princeedward/senior_thesis/README.md

senior_thesis
=============

A repo for codes and tex file of my senior design and thesis
