princeedward/senior_thesis/Tex/body/chapter3.tex

%%==================================================
%% chapter03.tex for SJTU Bachelor Thesis
%% version: 0.5.2
%% Encoding: UTF-8
%%==================================================

% \bibliographystyle{sjtu2} %[此处用于每章都生产参考文献]

\chapter{通用控制电路设计}
\label{chap:electricalSystem}
模块化机器人的各个模块都是可以独立工作的个体。从上一章的设计可知，每个模块都有一个核心板载系统来对本模块的基本功能进行控制。这一设计思路在其它模块化机器人上也有所体现。例如美国加州大学戴维斯分校的Graham G. Ryland等人\upcite{ryland2010design}设计的模块化机器人系统，每个模块是包含四个自由度的可以独立控制并运动的个体。而个体之间通过通信和协议来完成作为组合的总体所实现的功能。在本设计中，因为每个模块都有不同的功能，进行拼装后的实体的机器人通过协同来实现全部功能。为了使设计的硬件能在最大程度上实行公用，本设计将机器人电路进行拆分，并对电路实现了模块化。

每个机器人模块都将实现作为一个模块的基本功能，如实现与其他模块的通信；单独的程序上传与下载、与在线调试；对于自身模块的电源管理；与外部其他系统的通讯；简单的片上调试按钮和指示用数码管和LED。据此本方案设计了每个模块都要使用的通用模块控制电路。而对于不同模块的不同功能需求，本方案设计了大量的外设电路，每一个模块将会在功能性外设及接口设计部分进行讨论与说明。这样的好处是使每一个模块都拥有其工作所用的资源而不会有资源的浪费。例如，用于定位的IMU模块只有地盘模块需要使用。而上层实现其他功能的模块，如机械手并不需要使用，这里没有把其集成在通用板上，是极大的避免了资源的浪费。为了能够使用这些外设电路，本设计已经将片上所有资源系数引出。这样做同时还可供未来通用板的扩展。

以下各小节将对整个机器人系统的电路系统进行详细阐述。

\section{通用模块控制电路}
通用电路板本着简单，稳定，可以快速开发和方便部署的原则进行了设计。控制芯片选用了引脚众多，功能强大和文档完善的Freescale公司的MC9S12XS128单片机。本设计使用的是拥有112个引脚的版本。这款芯片的特点是低功耗、高集成、易于扩展，自带看门狗计数器、PWM输出、增强型捕捉定时器\upcite{xn2012baseon}。在本设计中，将通用控制电路板分为两个部分，一个部分是包含BWM程序烧写在线调试器，复位按键和单片机芯片的最小系统；另一部分是提供通用电路功能的接口板。这样设计而不是直接将单片机焊接在接口板上的原因是，一旦单片机烧毁，可以同过更换最小系统来使电路板恢复使用，而不用丢弃整个电路板基板上昂贵芯片。

下面的部分将对这两个模块进行详细的介绍。

\subsection{最小系统}
最小系统的电路图如图\ref{fig.CoreSch} 所示。最小系统实物图如图\ref{fig.CorePhoto} 所示。 \\
\begin{figure}[!htp]
  \centering
  
  \bicaption[fig.CorePhoto]{最小系统实物图}{最小系统实物图}{Fig}{the Minimal Core System}
\end{figure}
\begin{figure}[!htp]
  \centering
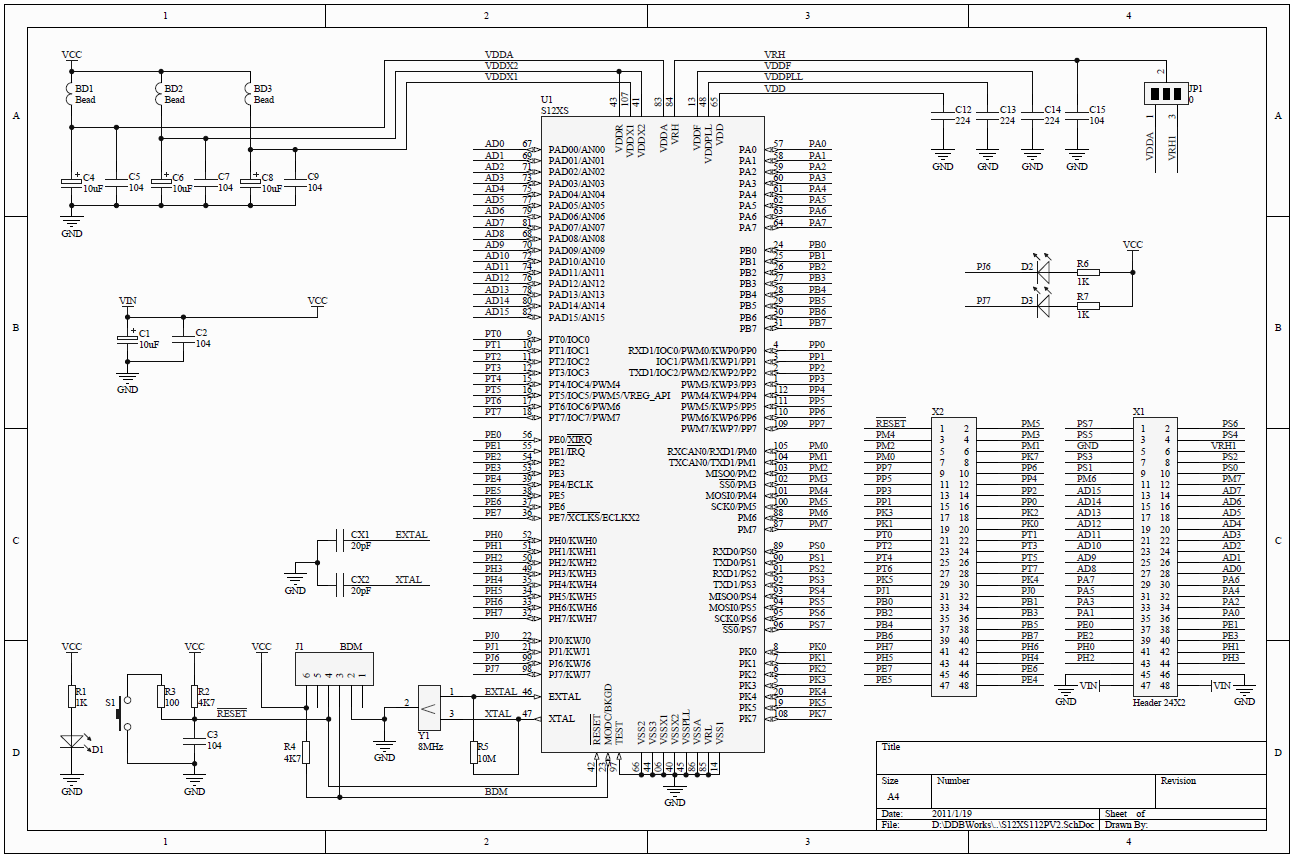
[picture p1: Tex/figures/chap3/CoreBoard.PNG]
  
  \bicaption[fig.CoreSch]{最小系统电路图}{最小系统电路图}{Fig}{Schematic of the Minimal Core System}
\end{figure}

这块最小系统板上有一个16MHz的晶振连接至芯片。芯片正常工作时的频率是由锁相环（PLL）超频到40MHz的。这块最小系统还有一个复位键，引入芯片RESET引脚，将检测电路的下降沿进行复位。同时最小系统上还提供一个BWM程序上传和下载及在线调试模块。片上提供128k片上RAM，可以用来储存芯片执行用程序。还有一个独立的电源管理模块，以提供稳定的5v电压给单片机工作。之所以称为最小系统，就是因为以上是这块芯片的全部功能元件。如原理图所示，这块最小系统的其他功能就是简单的将单片机所有引脚引出。 

\subsection{功能接口板}
功能接口板是通用模块控制电路的核心部分。它具有承上启下的作用，得到最小系统引出的单片机全部空余引脚，并对其功能进行设计。其电路图如图\ref{fig.BaseSch} 所示。 其共分为电源管理，CAN总线，单片机接口，电压测试单元，串口通讯，数码管显示单元，LED及案件阵列和引出接口几部分。 
\begin{figure}[!htp]
  \centering
  %\bicaption[fig.BaseSch]{功能接口板电路图}{功能接口板电路图}{Fig}{Schematic of Base Board}
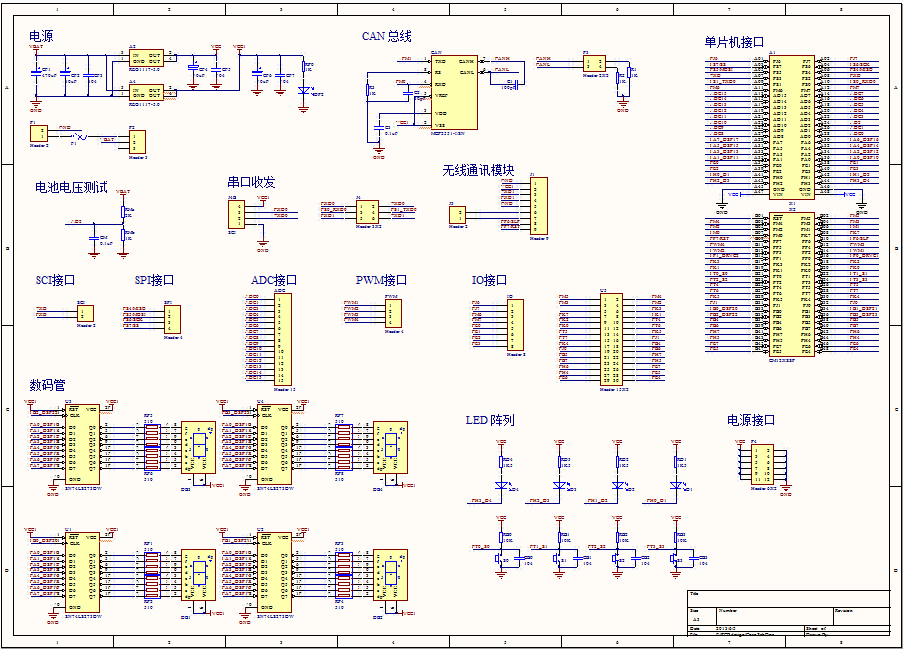
[picture p2: Tex/figures/chap3/CoreBoardSchematic.PNG]
  
  \bicaption[fig.BaseSch]{功能接口板电路图}{功能接口板电路图}{Fig}{Schematic of Base Board}
\end{figure}

其中电源管理部分的电路如图\ref{fig.BaseScrMg}。使用两片1117输出两个5v电压，为了使电流相差较大模块之间不会相互干扰。其中一个给单片机及通讯模块供压，电流小，对电流稳定性要求高；而另一路主要给外设电路供压。 
\begin{figure}[!htp]
  \centering
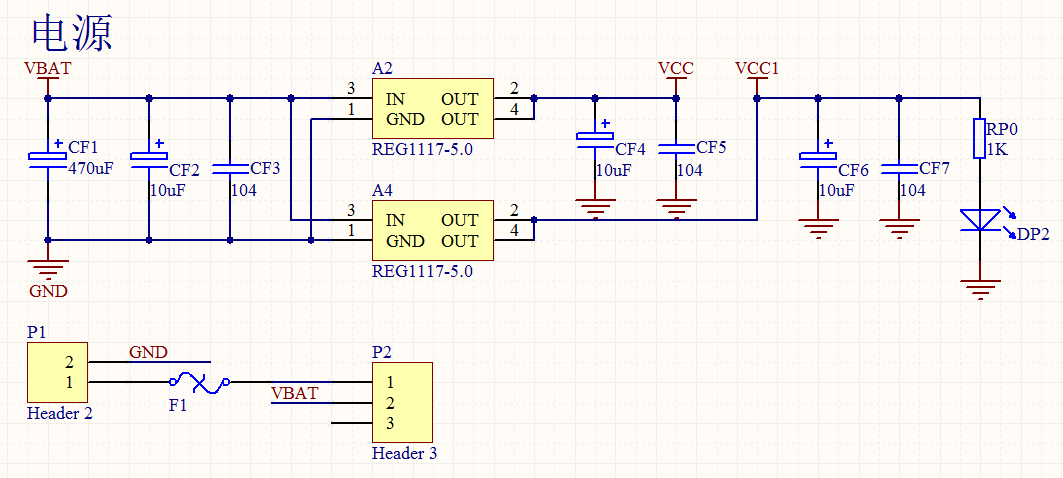
[picture p3: Tex/figures/chap3/CoreBoardPowerMg.PNG]
  
  \bicaption[fig.BaseScrMg]{电源管理电路原理图}{电源管理电路原理图}{Fig}{Schematic of Power Source Management Unit}
\end{figure}

CAN总线电路图如图所示\ref{fig.BaseCAN} 。用一块Microchip公司生产的MCP2511作为单片机内置CAN模块的Transceiver，将CAN端口数据打包编码后传输到总线中去。前面已经介绍过了这款机器人将打破传统的接触式传输连线，而是使用光学方法进行数据传输，其中这里CAN总线的输出口，就是要连接到光学传输接口板上。关于光学传输接口板的具体信息将在下面的模块间通讯接口小节进行详细的介绍。
\begin{figure}[!htp]
  \centering
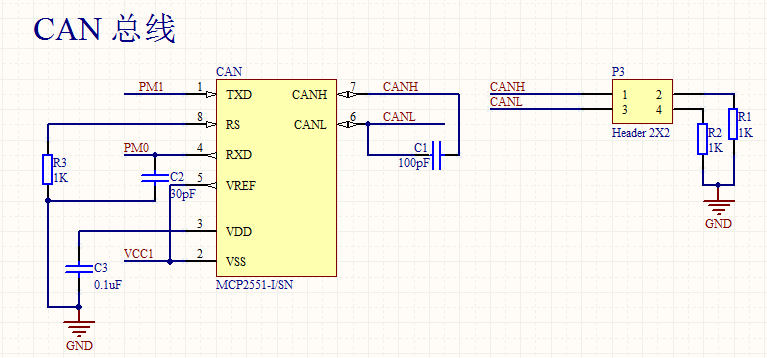
[picture p4: Tex/figures/chap3/CoreBoardCANBus.PNG]
  
  \bicaption[fig.BaseCAN]{CAN电路原理图}{CAN电路原理图}{Fig}{Schematic of CAN Bus Unit}
\end{figure}

CAN总线2.0协议\upcite{bosch1991can}是由博世公司提出被提供支持的。因为其两线制的机制，和可以同时连接非常多个模块，并能组织各个节点模块共同工作的特点而大量应用在汽车领域。其传输速度快，稳定性强的特点也为其能轻松移植到机器人系统中来提供了可行性。相对较少的接线同时也意味着极大的容错率，这就是本设计选择CAN总线为模块间传输工具的原因。这一设计的灵感来源于Ying Zhang等人\upcite{zhang2002massively}的研究。

功能接口板的PCB设计图如图\ref{fig.CorePCB} 所示。其虚拟实物图如图\ref{fig.CoreReal} 所示，3D立体仿真图如图\ref{fig.Core3D} 所示。 
\begin{figure}
  \centering
  \subfigure[PCB正面]{
    \label{fig:corepcb:a} %% label for first subfigure
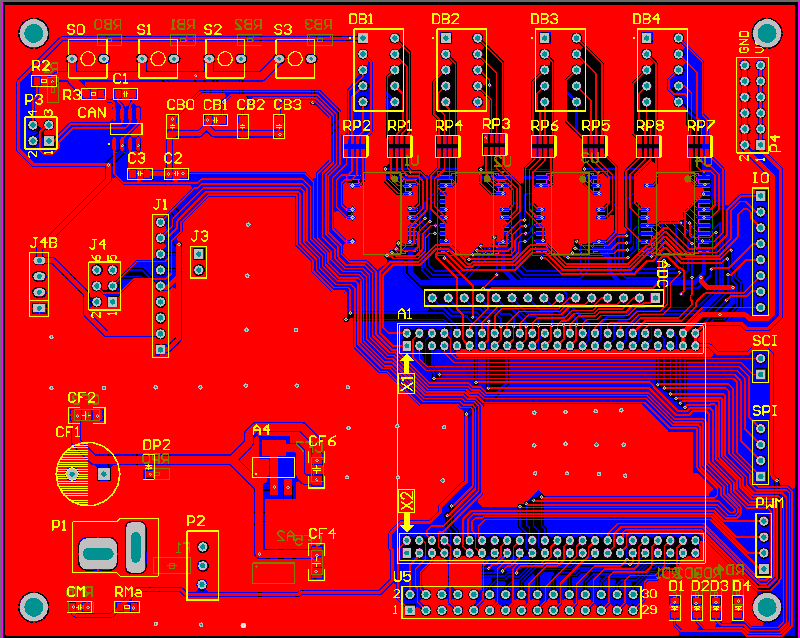
[picture p5: Tex/figures/chap3/CoreBoardTop.PNG]
    }
  \hspace{1in}
  \subfigure[PCB背面]{
    \label{fig:corepcb:b} %% label for second subfigure
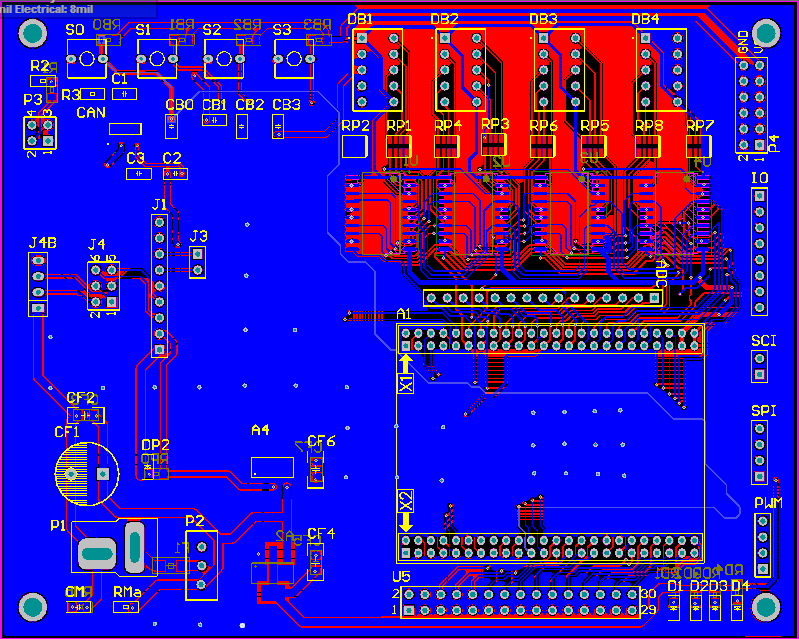
[picture p6: Tex/figures/chap3/CoreBoardBottom.PNG]
    }
  \bicaption[fig.CorePCB]{功能接口板的设计PCB样图}{功能接口板的设计PCB样图}{Fig}{The PCB View of Main Base Board}
\end{figure}
\begin{figure}
  \centering
  \subfigure[PCB正面]{
    \label{fig:corereal:a} %% label for first subfigure
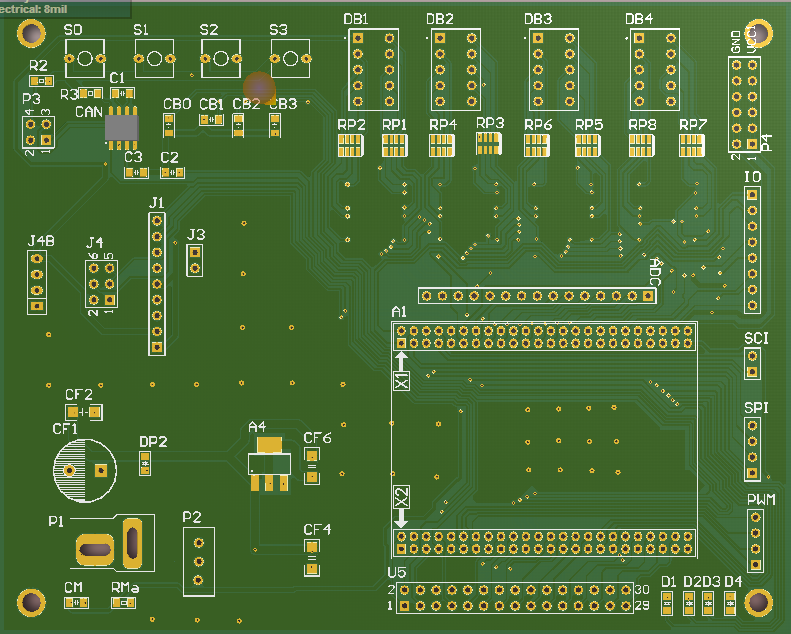
[picture p7: Tex/figures/chap3/CoreBoardManTop.PNG]
    }
  \hspace{1in}
  \subfigure[PCB背面]{
    \label{fig:corereal:b} %% label for second subfigure
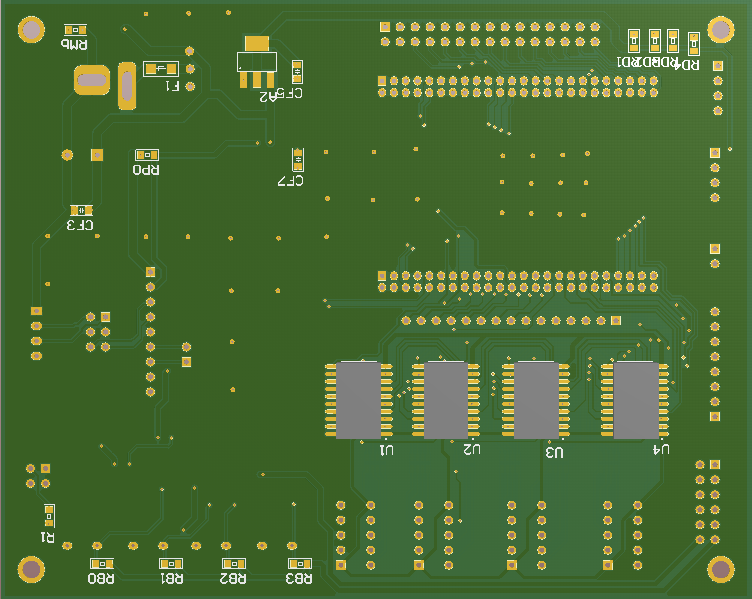
[picture p8: Tex/figures/chap3/CoreBoardManBottom.PNG]
    }
  \bicaption[fig.CoreReal]{功能接口板的虚拟实物图}{功能接口板的虚拟实物图}{Fig}{The Virtual View of Main Base Board}
\end{figure}
\begin{figure}[!htp]
  \centering
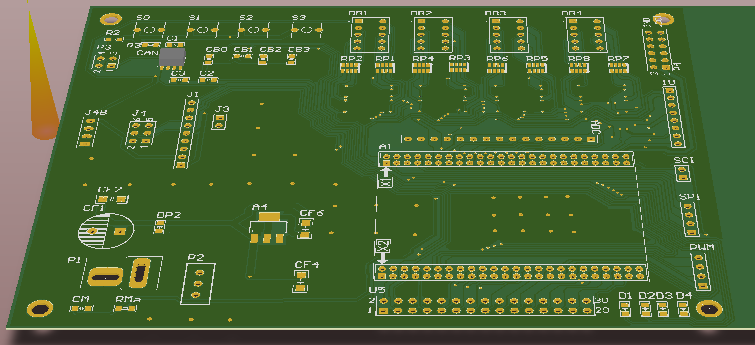
[picture p9: Tex/figures/chap3/CoreBoard3D.PNG]
  
  \bicaption[fig.Core3D]{功能接口板的虚拟实物图3D}{功能接口板的虚拟实物图3D}{Fig}{The 3D Virtual View of Main Base Board}
\end{figure}
\section{功能型外设及接口设计}
功能性外设主要提供某个模块所需要的独特功能。这些模块可能包括机器人应用中的方方面面。如无线通讯模块：用来使每个机器人模块与外部设备，如远程计算通讯，从而实现信息的沟通或是机器人与远程系统的交互；IMU和GPS模块：用来实现定位，机器人姿态探测等功能；电机驱动模块，用来驱动电机，可以用在轮式底盘或是履带式底盘的驱动；编码器模块：可以用来对固定于某一电机或伺服电机舵机上的编码器进行驱动与计数；传感器模块：用来驱动传感器来对外部信息进行采集和处理；以及其他应用领域的模块等等。本设计因为只对移动平台进行了设计及研究，所以只具体设计了IMU模块，电机驱动模块，编码器模块，传感器模块和光电CAN传输模块。对于每一个模块的详细设计如下。

\subsection{IMU模块}
IMU是Inertial measurement unit（惯性测量单元）的缩写。本方案所设计的IMU包括传统的加速度计和陀螺仪，同时参考了Minor等人\upcite{minor2001utilization}的设计，在模块中引入了磁倾角传感器（电子罗盘）。在这一模块的设计中，使用了一片SCA100T两轴角速度传感器，用来采集平行于地面的平面内的加速度；一个ZCC212N电子罗盘封装单元，这一单元将测得的与地磁场倾角数据通过SCI协议传输回单片机进行处理；以及一个LYPR540三轴陀螺仪，用以测量角加速度。电路设计原理图如图\ref{fig.IMUSch} 所示，PCB设计样图如图\ref{fig.IMUPCB} 所示，虚拟实物图如图\ref{fig.IMUReal} 所示。 
\begin{figure}[!htp]
  \centering
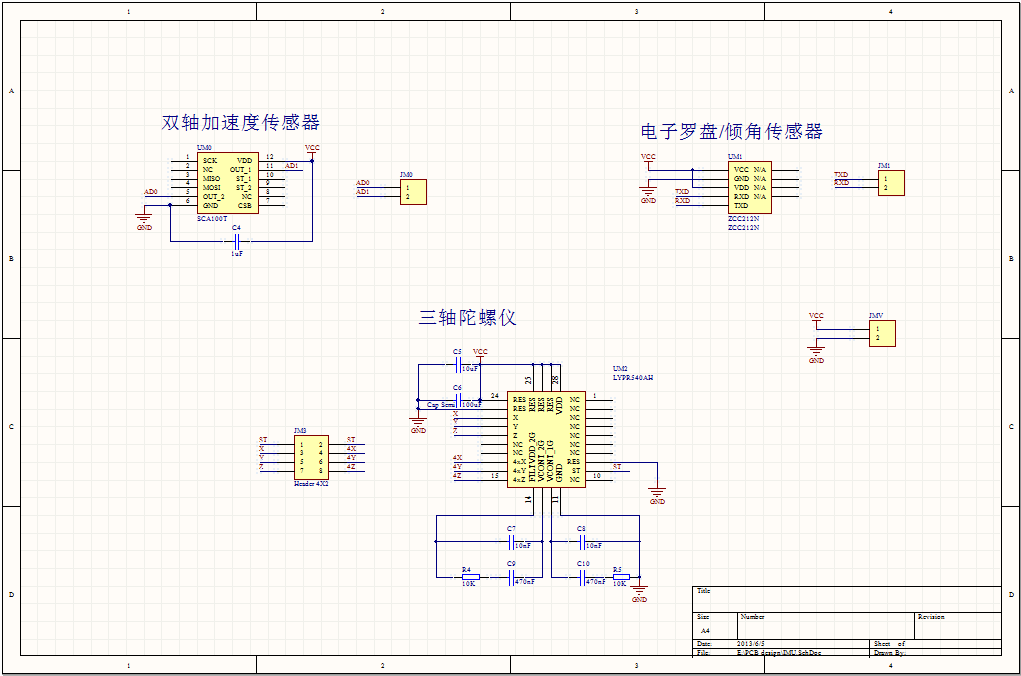
[picture p10: Tex/figures/chap3/IMU.PNG]
  
  \bicaption[fig.IMUSch]{IMU电路原理图}{IMU电路原理图}{Fig}{Schematic of IMU Unit}
\end{figure}
\begin{figure}
  \centering
  \subfigure[PCB正面]{
    \label{fig:corepcb:a} %% label for first subfigure
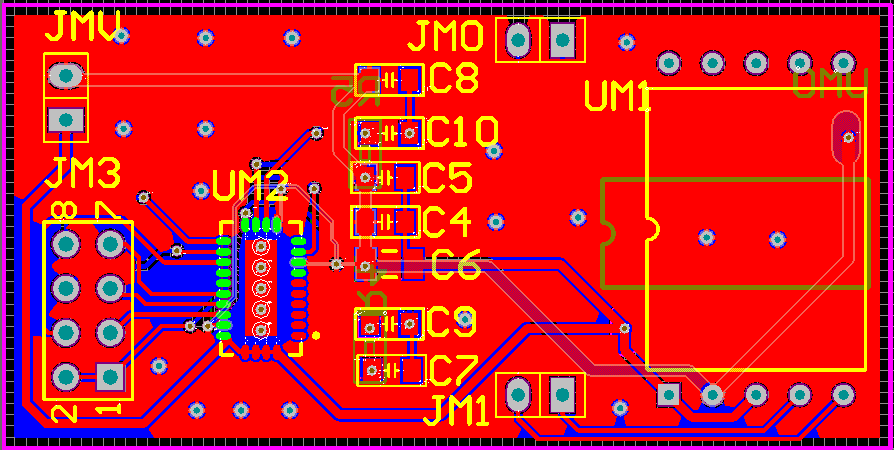
[picture p11: Tex/figures/chap3/IMUfront.PNG]
    }
  \hspace{1in}
  \subfigure[PCB背面]{
    \label{fig:corepcb:b} %% label for second subfigure
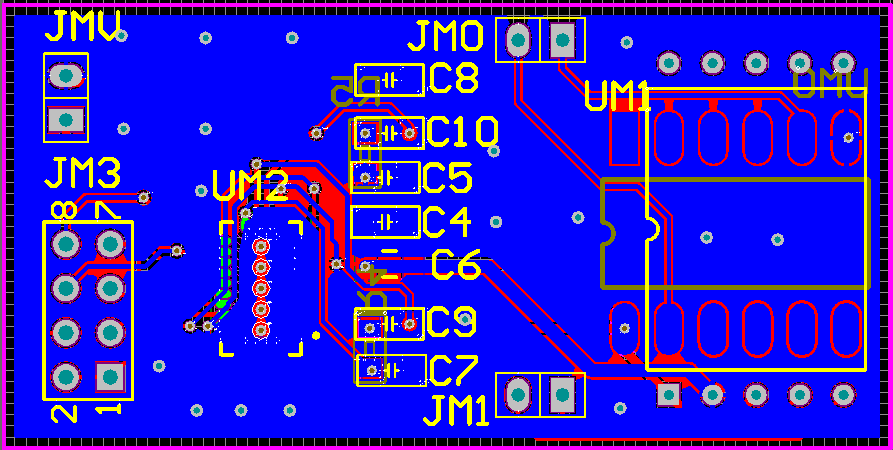
[picture p12: Tex/figures/chap3/IMUback.PNG]
    }
  \bicaption[fig.IMUPCB]{IMU的设计PCB样图}{IMU的设计PCB样图}{Fig}{The PCB View of IMU}
\end{figure}
\begin{figure}
  \centering
  \subfigure[PCB正面]{
    \label{fig:corereal:a} %% label for first subfigure
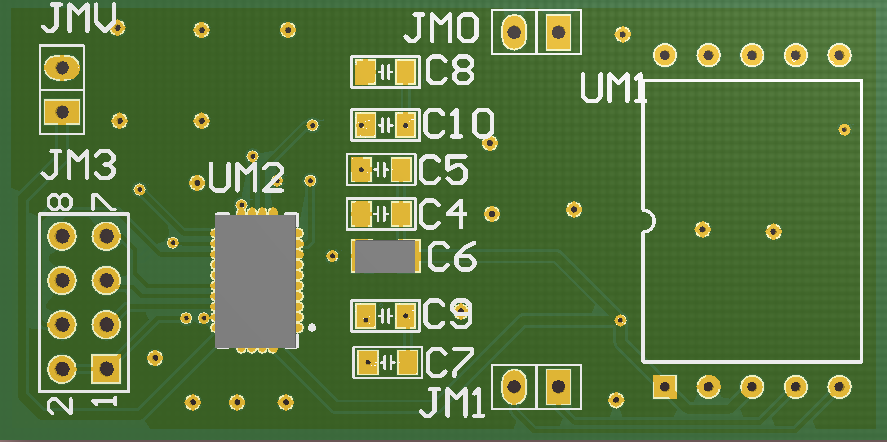
[picture p13: Tex/figures/chap3/IMUfrontVr.PNG]
    }
  \hspace{1in}
  \subfigure[PCB背面]{
    \label{fig:corereal:b} %% label for second subfigure
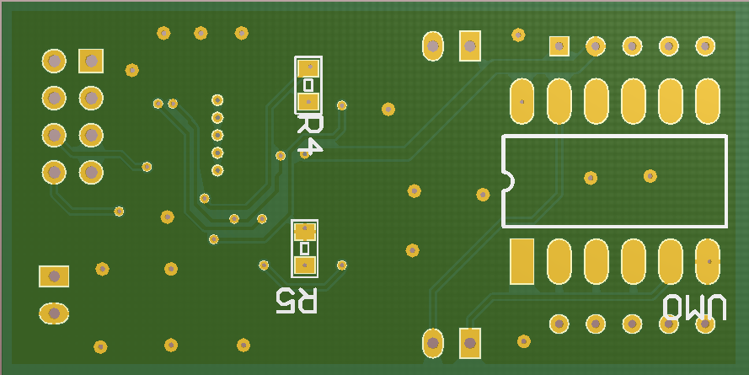
[picture p14: Tex/figures/chap3/IMUbackVr.PNG]
    }
  \bicaption[fig.IMUReal]{IMU的虚拟实物图}{IMU的虚拟实物图}{Fig}{The Virtual View of IMU}
\end{figure}

\subsection{驱动模块}
本方案的驱动电路是直接基于BTS7960式H桥芯片设计的。同时电机需要使用PWM脉冲调制器产生方波来进行控速，通过改变方波的占空比来改变作用在电机上的等效电压来实现调速。其原理图如图\ref{fig.Drv} 所示,PCB设计样图如图\ref{fig.DrvPCB} 所示。
\begin{figure}[!htp]
  \centering
  \bicaption[fig.Drv]{驱动电路电路图}{驱动电路电路图}{Fig}{Schematic of Driver Board}
  
\end{figure}
\begin{figure}
  \centering
  \subfigure[PCB正面]{
    \label{fig:corepcb:a} %% label for first subfigure
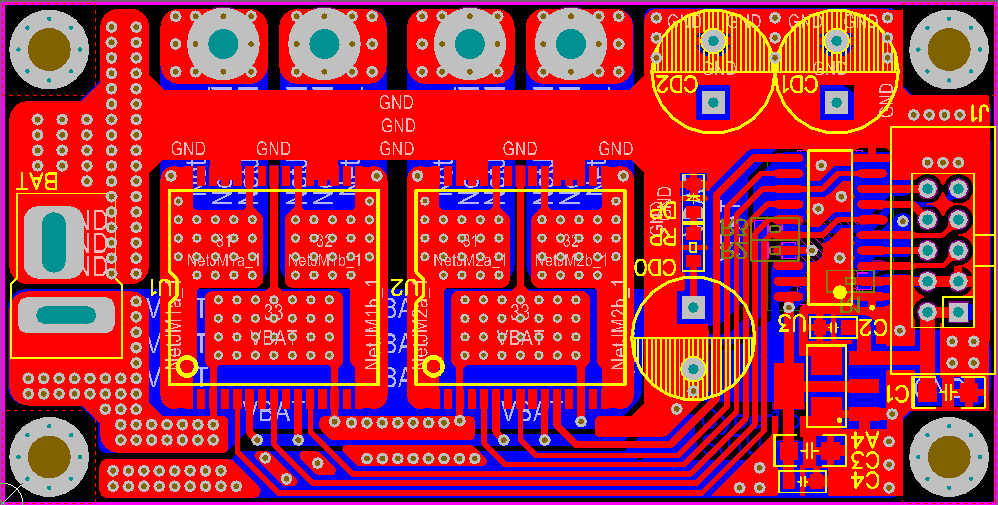
[picture p15: Tex/figures/chap3/DrvPCBTop.PNG]
    }
  \hspace{1in}
  \subfigure[PCB背面]{
    \label{fig:corepcb:b} %% label for second subfigure
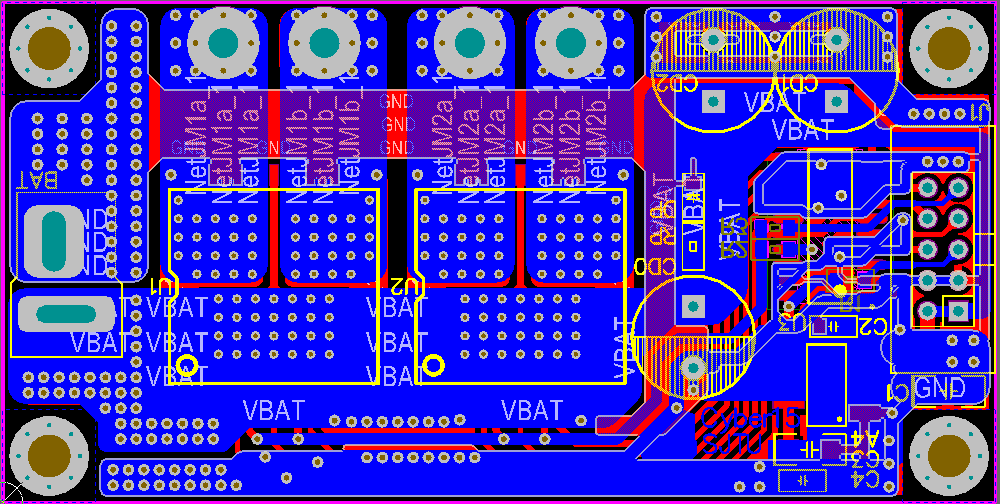
[picture p16: Tex/figures/chap3/DrvPCBBack.PNG]
    }
  \bicaption[fig.DrvPCB]{驱动电路的设计PCB样图}{驱动电路的设计PCB样图}{Fig}{The PCB View of Driver Board}
\end{figure}

\subsection{编码器模块}
编码器模块实际上是比较简单的模块，其主要功能是为编码器提供片外计数器，并把结果反馈给主控板。在本设计中，选用的是CD4520芯片。这是一个最高计数值较小的高速用计数器。每个芯片的接线方法的电路原理图如图\upcite{ConSch}。\\
\begin{figure}[!htp]
  \centering
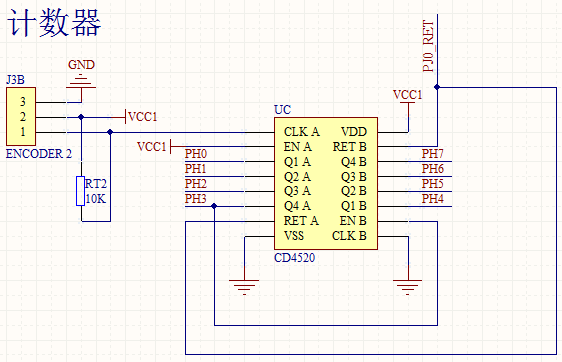
[picture p17: Tex/figures/chap3/counter.PNG]
  
  \bicaption[fig.ConSch]{编码器用外部计数器接线图}{编码器用外部计数器接线图}{Fig}{Schematic of counters for encoder}
\end{figure}
\subsection{传感器模块}
传感器模块需要因传感器种类的不同而不同。在这里只对本设计需要用的超声波传感器的驱动电路进行讨论。因为传感器众多，为了节省片上资源，需要新的方法去驱动这么多传感器。其中一种方案就如笔者的设计，轮流激活传感器网络中的各个个体，这样可以复用同一套数据读取口，只需要不同的选通IO接口就可以了。这种方法充分的考虑到了片上资源不足的情况，极大的减少所要使用IO口的数量。传感器驱动网络的原理图如图\ref{fig.ultraSonic}所示。从图中可以看出PK7口是复用的，是有上升沿和下降沿检测中断的端口。如果使用译码器驱动选通的话，可以以供使用4个IO口驱动8个传感器。
\begin{figure}[!htp]
  \centering
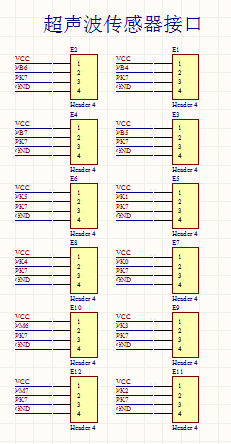
[picture p18: Tex/figures/chap3/ultraSonic.PNG]
  
  \bicaption[fig.ultraSonic]{超声波传感器驱动板原理图}{超声波传感器驱动板原理图}{Fig}{Schematic of Ultrasonics Driver Unit}
\end{figure}

在本设计中选用的传感器是比较常见的HC-SR04模块。其有效检测距离是4cm到8m。超声波传感器不同于红外传感器，抗光线和环境干扰能力比较强，相对可靠。同时因为模块的常见性，又使其非常廉价。这款模块的实物图如图\ref{fig.ultraSonicReal} 所示。 \\
\begin{figure}[!htp]
  \centering
  \subfigure[正面]{
    \label{fig:corepcb:a} %% label for first subfigure
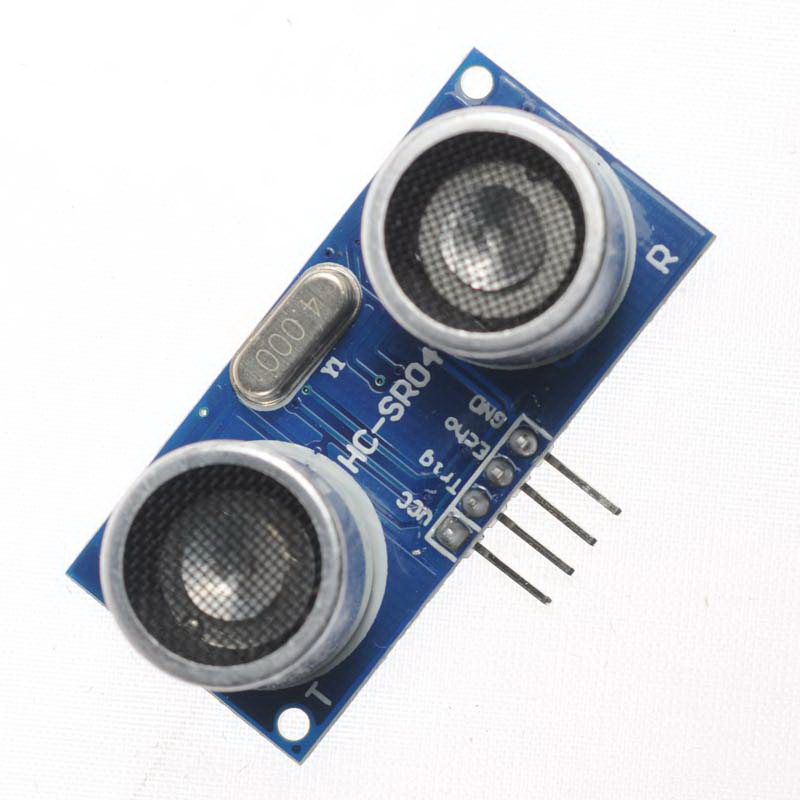
[picture p19: Tex/figures/chap3/HC_SR04.png]
    }
  \hspace{1in}
  \subfigure[背面]{
    \label{fig:corepcb:b} %% label for second subfigure
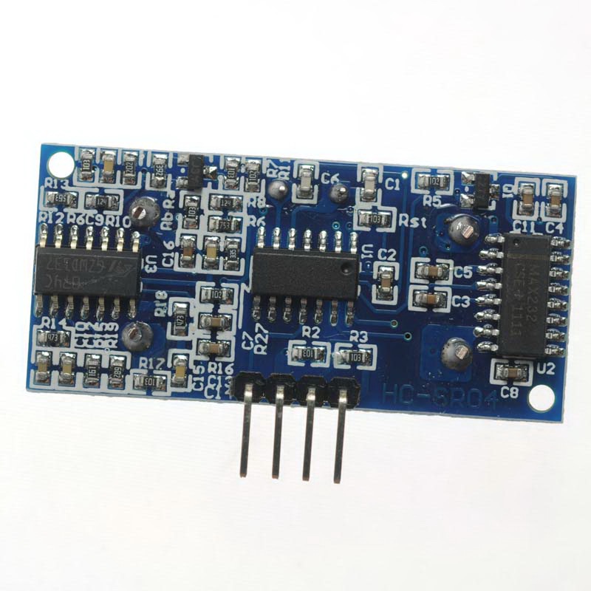
[picture p20: Tex/figures/chap3/HC_SR04back.png]
    }
  \bicaption[fig.ultraSonicReal]{超声波传感器}{超声波传感器}{Fig}{Ultrasonics Sensor Unit}
\end{figure}
\subsection{模块间通讯接口}
模块间通讯接口是本设计中很重要的一部分，也是本设计的一个创新点。在Ying Zhang\upcite{zhang2002massively} 的关于模块化机器人的大规模控制网络系统设计中,提供了使用CAN总线的模块化机器人网络进行控制的很好的解决方案。这套方案给出了一个在软件层面上可行的方法，受此启发，本设计将整个模块化机器人的相互通讯架构在CAN总线上。在前面的机械设计部分，对于为何使用光学式通道连接代替机械式触点连接给出了充分的解释。而在本章这是在电路硬件层面上将其实现。

对于CAN总线的每一条输出线都采用一对红外线光电对管来发送和接受相应线中的内容。CANH中是以2.5V为基电位的脉冲信号，最大幅值为5v；而CANL中是以0V为基电位的脉冲信号，最大幅值为2.5V。根据其这一特点，分别设计了CANH和CANL的发送单元。对于CANH是先将信号通过减法器，减去一个2.5V的参考电压，再输出到一个MOSFET的G极，控制红外LED的开关，来达到把信号发出的目的。CANL则可以直接减引脚接入MOSFET的G极来控制红外LED的亮灭。CANH和CANL的接收单元也不相同。因为接收到的光敏二极管的输出电压为一模拟值，所以要通过一定的方法把其变为数字值。对于CANH，输出电压先经过一个比较器，变为基值是0v，幅值是5V的脉冲信号，再通过加法器加上一个2.5V的参考电压，来变成基值为2.5V，最大幅值为5V的脉冲信号，并输出回CANH线。对于CANL线，情况相似，也是要先要经过一个比较器，在对脉冲信号进行调幅。这一模块的原理图如图所示，PCB设计样图如图\ref{fig.CANPPCB}所示，虚拟实物图如图\ref{fig.CANPReal}所示。
\begin{figure}[!htp]
  \centering
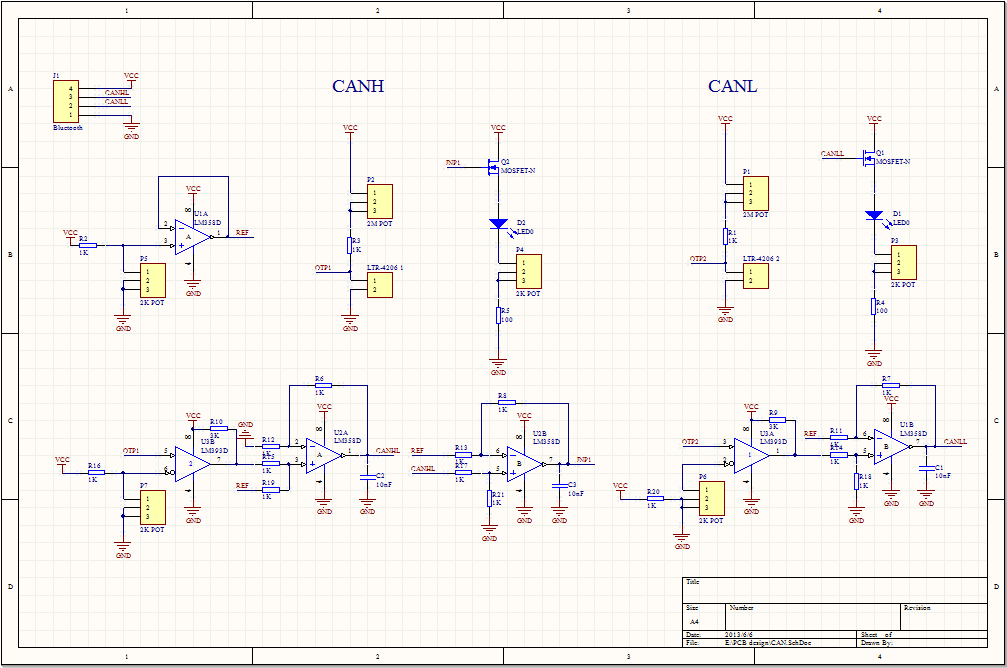
[picture p21: Tex/figures/chap3/CANCommunication.PNG]
  
  \bicaption[fig.CANPSch]{模块间通讯接口板电路原理图}{模块间通讯接口板电路原理图}{Fig}{Schematic of Modular Level Communication Unit}
\end{figure}
\begin{figure}
  \centering
  \subfigure[PCB正面]{
    \label{fig:corepcb:a} %% label for first subfigure
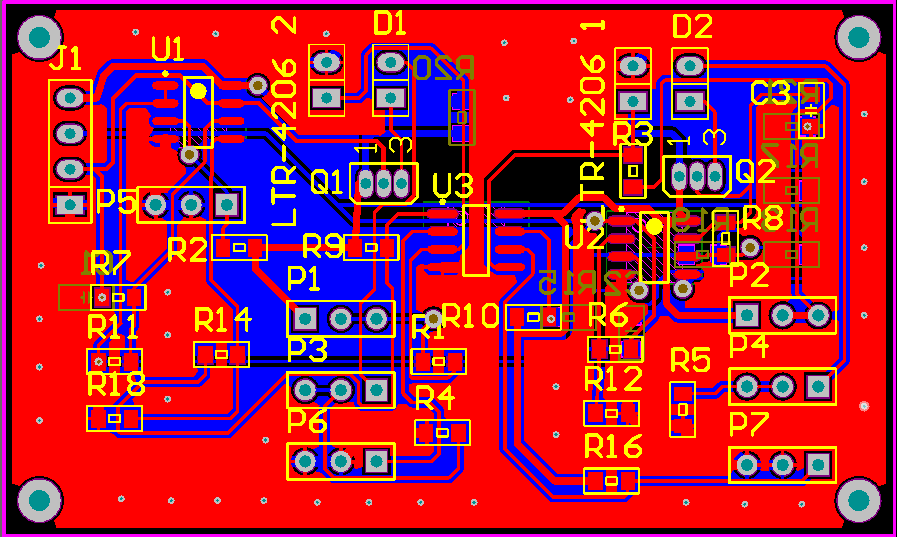
[picture p22: Tex/figures/chap3/CANportalTop.PNG]
    }
  \hspace{1in}
  \subfigure[PCB背面]{
    \label{fig:corepcb:b} %% label for second subfigure
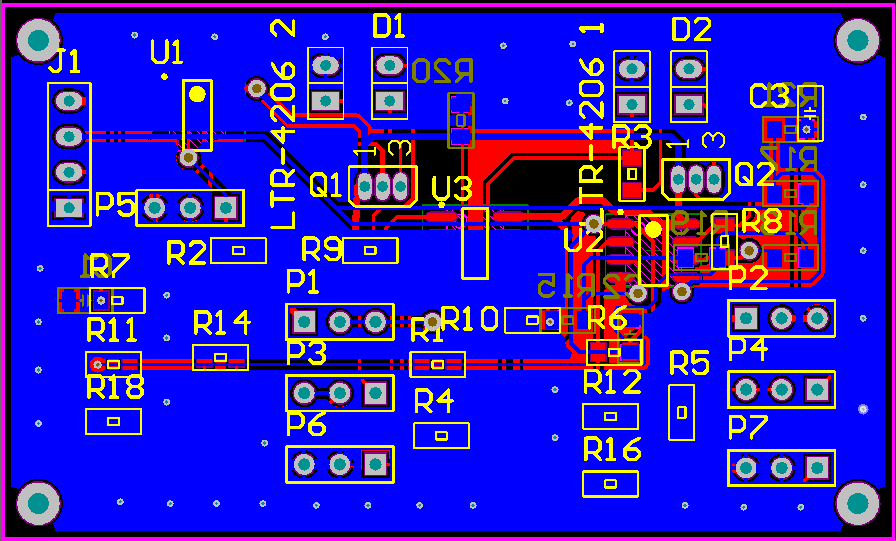
[picture p23: Tex/figures/chap3/CANportalBottom.PNG]
    }
  \bicaption[fig.CANPPCB]{模块间通讯接口板设计PCB样图}{模块间通讯接口板设计PCB样图}{Fig}{The PCB View of Modular Level Communication Unit}
\end{figure}
\begin{figure}
  \centering
  \subfigure[PCB正面]{
    \label{fig:corereal:a} %% label for first subfigure
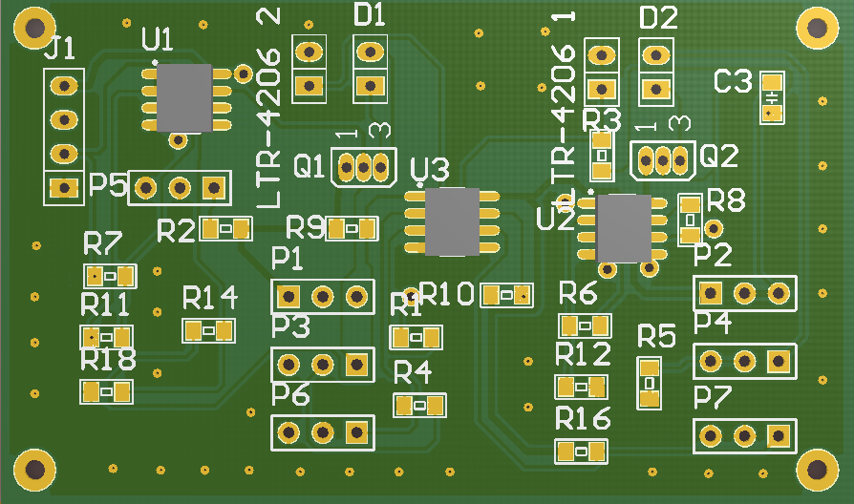
[picture p24: Tex/figures/chap3/CANRealTop.PNG]
    }
  \hspace{1in}
  \subfigure[PCB背面]{
    \label{fig:corereal:b} %% label for second subfigure
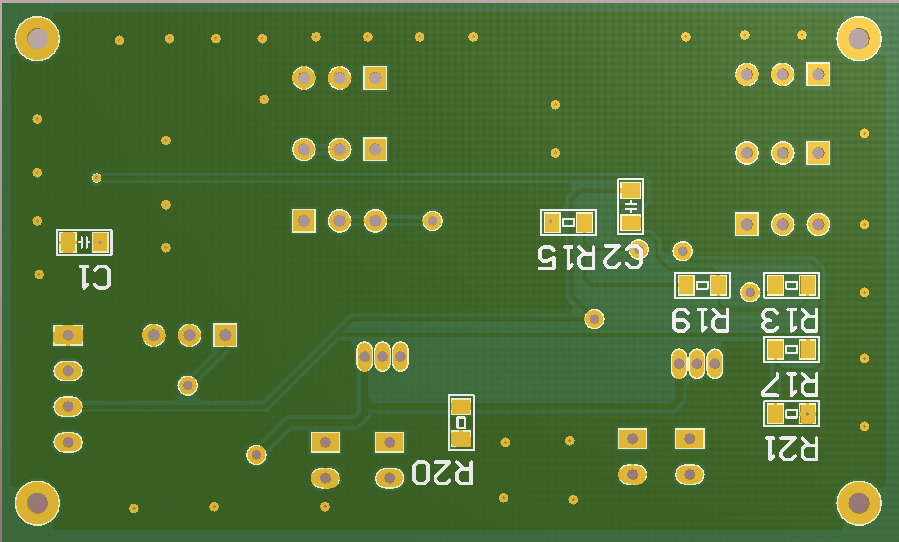
[picture p25: Tex/figures/chap3/CANRealBttom.PNG]
    }
  \bicaption[fig.CANPReal]{模块间通讯接口板虚拟实物图}{模块间通讯接口板虚拟实物图}{Fig}{The Virtual View of Modular Level Communication Unit}
\end{figure}
\section{本章小结}
本章对多功能模块化机器人的控制系统的电路系统部分的设计进行了详尽的说明。对于每个模块化机器人来说，其电路系统分为两个部分，一个是通用模块控制电路，一个是外设功能电路。通用控制电路实现模块化机器人每个模块的基本功能，并提供足够的扩展接口；外设功能电路是帮助模块使某一功能具体实现的电路。不同的模块可以选择需要的外设功能，以在实现期望功能的前提下，减少资源的浪费。
