princeedward/senior_thesis/Tex/body/ack.tex

%%==================================================
%% thanks.tex for SJTU Bachelor Thesis
%% version: 0.5.2
%% Encoding: UTF-8
%%==================================================

\begin{thanks}
  本设计论文的完成离不开费燕琼老师的帮助与指导，特此表示感谢。在电路的设计上，电院自动化系王冰老师的设计给了我许多启发，同时也得到过工训中心宋立博老师的意见，在此一并感谢。关于超声波传感器的选用来自于几次与陆正辰学长的谈话，对其能给我提供这么好的建议，同样表示感谢。在实验室进行项目期间，得到了吕海洋学长的大力支持与帮助，对此我表示由衷的谢意。关于GAZEBO的使用要感谢我在外国实验室的PhD学生Nick，是他将这么好的动力学仿真软件介绍给我的。还要感谢国外的Finie老师，使我第一次接触到了IMU模块，以及我的国外的导师Mark，是他在CAN总线通讯上给了我启发。最后，感谢所有在设计当中给我提供意见与帮助的老师同学！
  
\end{thanks}
