princeedward/senior_thesis/Tex/figures/chap3/CoreMinSys.jpg

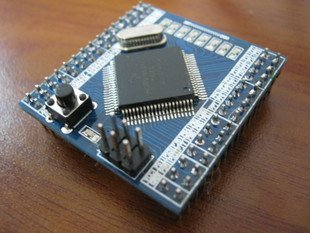
Tex/figures/chap3/CoreMinSys.jpg
