princeedward/senior_thesis/Tex/figures/chap3/DRVschematic.PNG

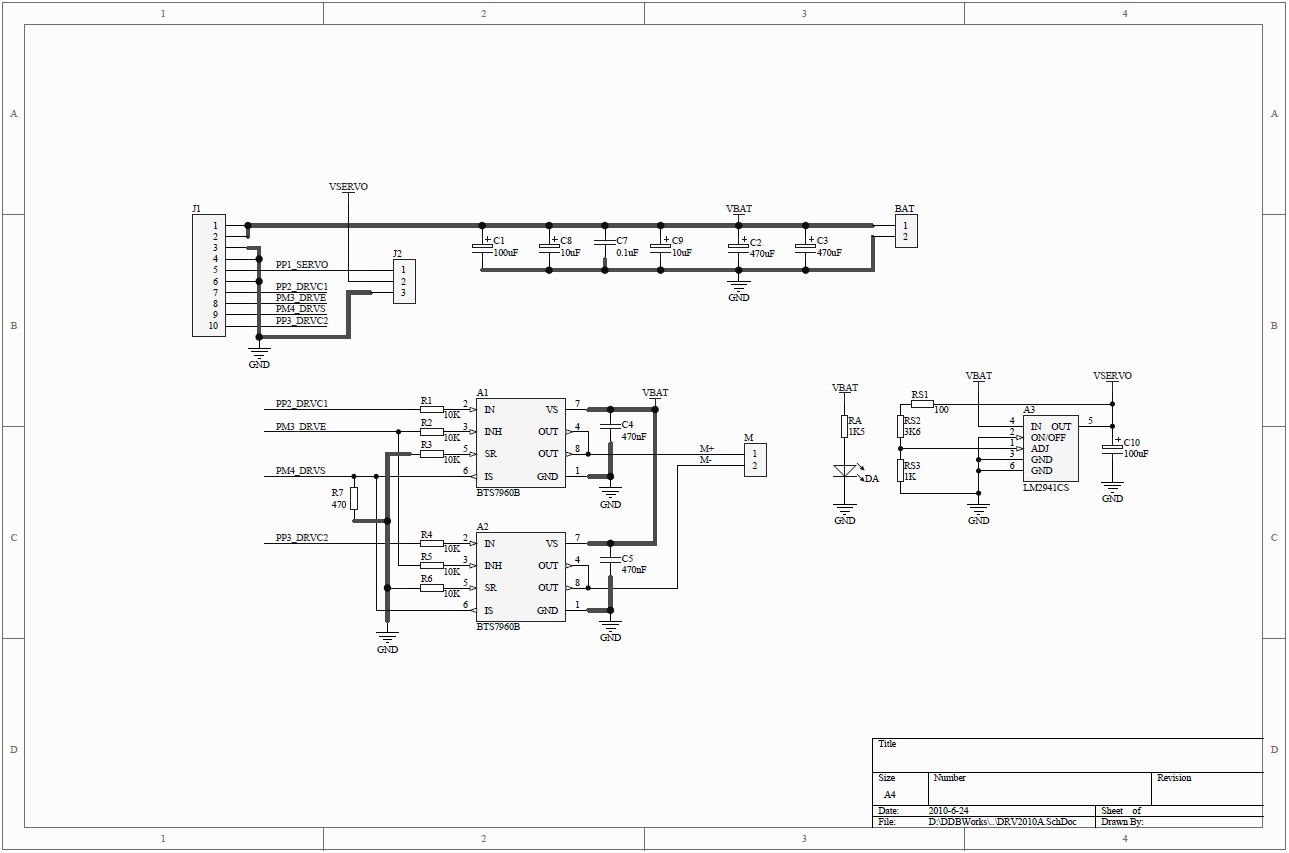
Tex/figures/chap3/DRVschematic.PNG
