princeedward/senior_thesis/Tex/figures/chap3/H_Bridge.jpg

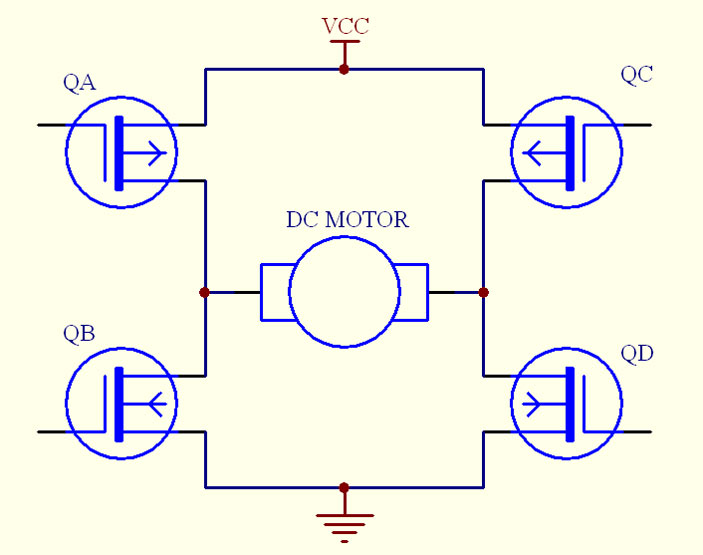
Tex/figures/chap3/H_Bridge.jpg
