princeedward/senior_thesis/Tex/figures/chap5/Maze.jpg

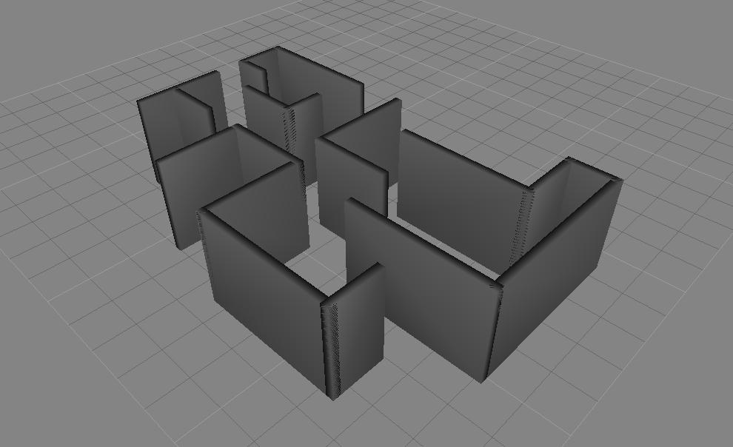
Tex/figures/chap5/Maze.jpg
