princeedward/senior_thesis/Design/Encode Wheel Structure.SLDASM

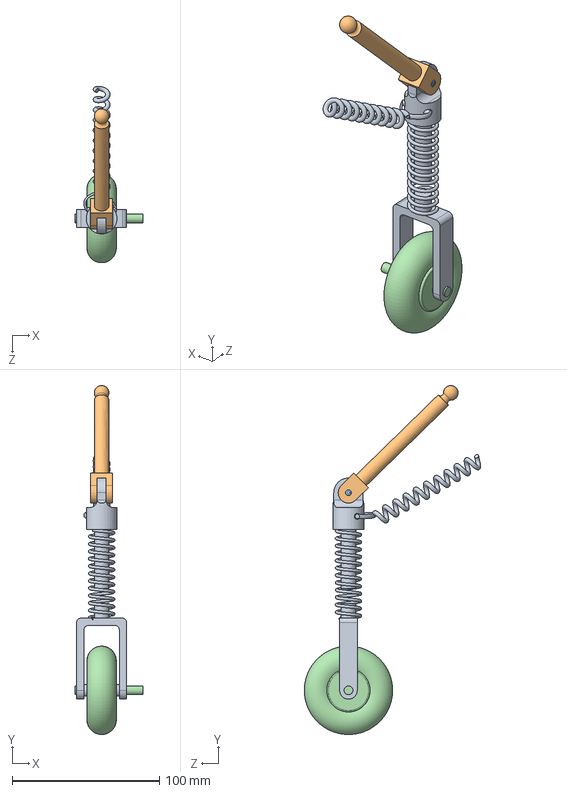
[picture p58: CAD file, 2013-06-06]
Design/Encode Wheel Structure.SLDASM
46.0 x 236.7 x 119.7 mm
Encoder Wheel
Upper Link
Axial
Wheel
