princeedward/senior_thesis/Design/Encoder Wheel.SLDPRT

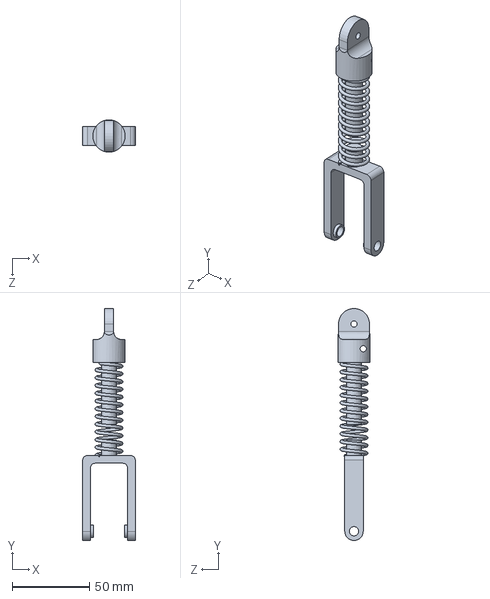
[picture p59: CAD file, 2013-06-14]
Design/Encoder Wheel.SLDPRT
34.0 x 150.0 x 20.9 mm
