princeedward/senior_thesis/Design/Encoder Wheel Spring.SLDPRT

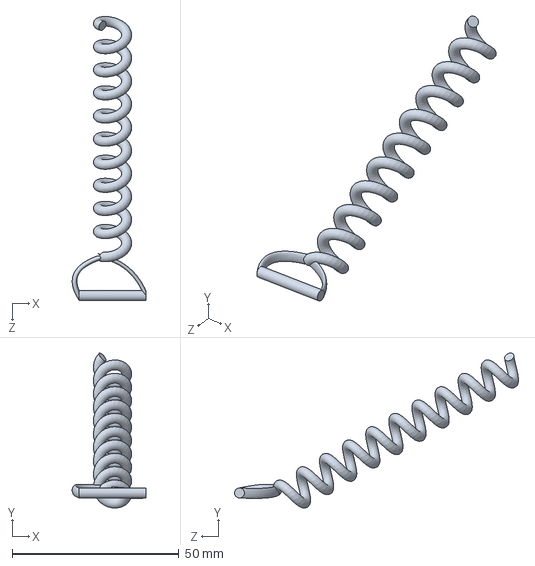
[picture p60: CAD file, 2013-06-14]
Design/Encoder Wheel Spring.SLDPRT
22.1 x 46.5 x 85.2 mm
