princeedward/senior_thesis/Design/Axial.SLDPRT

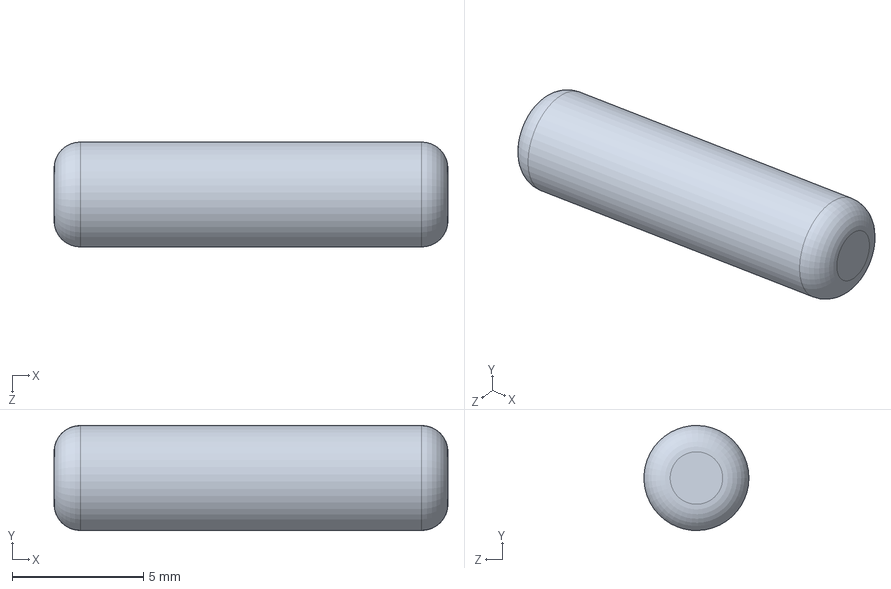
[picture p61: CAD file, 2013-06-06]
Design/Axial.SLDPRT
15.0 x 4.00 x 4.00 mm
