princeedward/senior_thesis/Design/Upper Link.SLDPRT

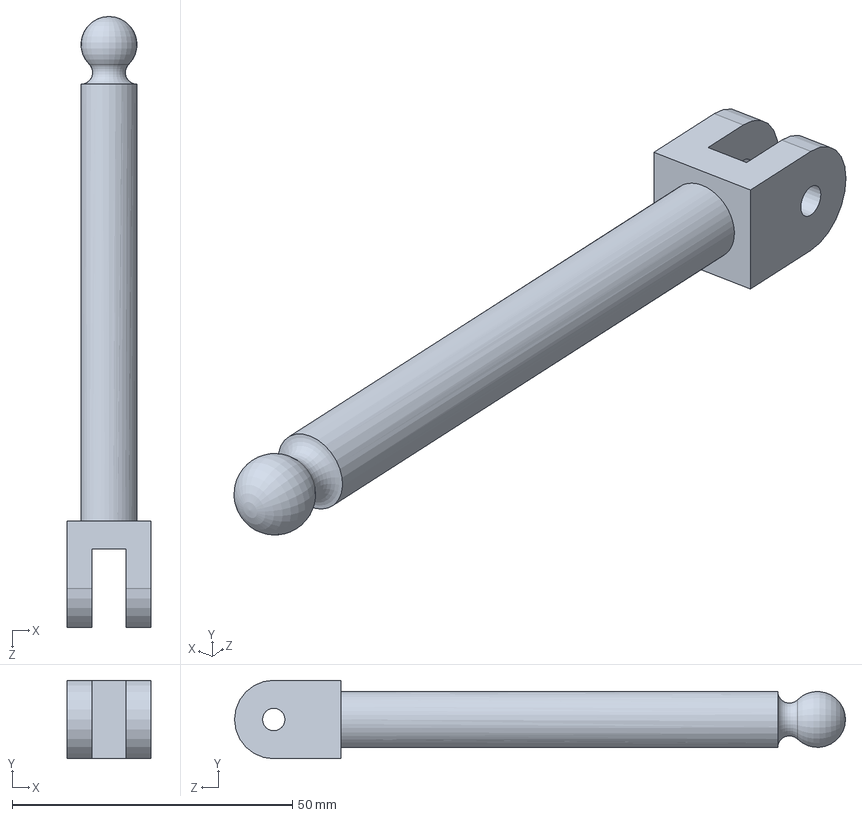
[picture p62: CAD file, 2013-06-06]
Design/Upper Link.SLDPRT
15.0 x 14.0 x 109.0 mm
