princeedward/senior_thesis/Design/Wheel.SLDPRT

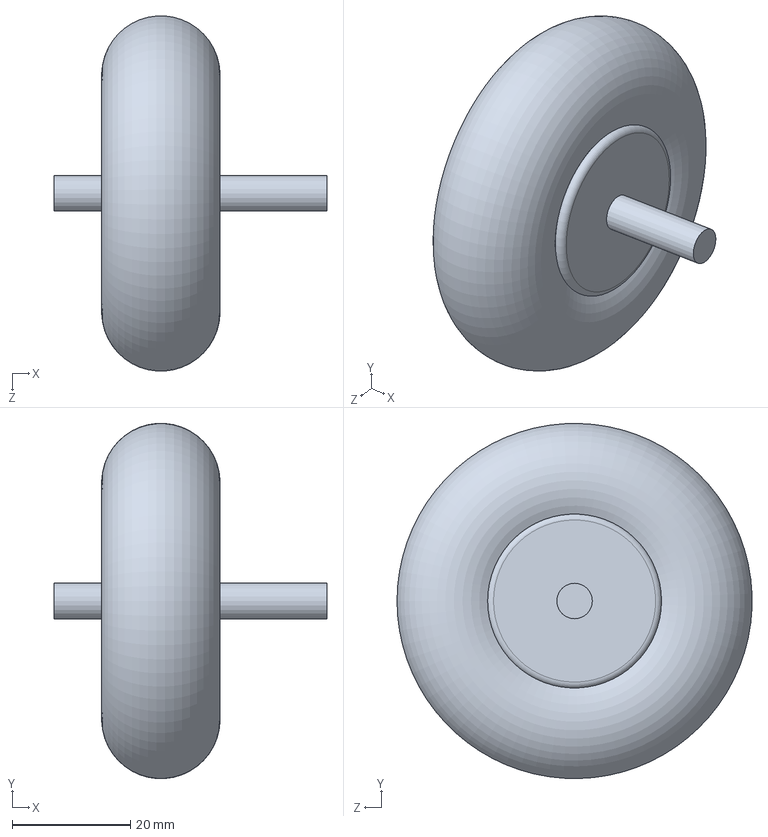
[picture p63: CAD file, 2013-06-06]
Design/Wheel.SLDPRT
46.0 x 59.9 x 59.9 mm
