princeedward/senior_thesis/Design/Module Communication Port.SLDPRT

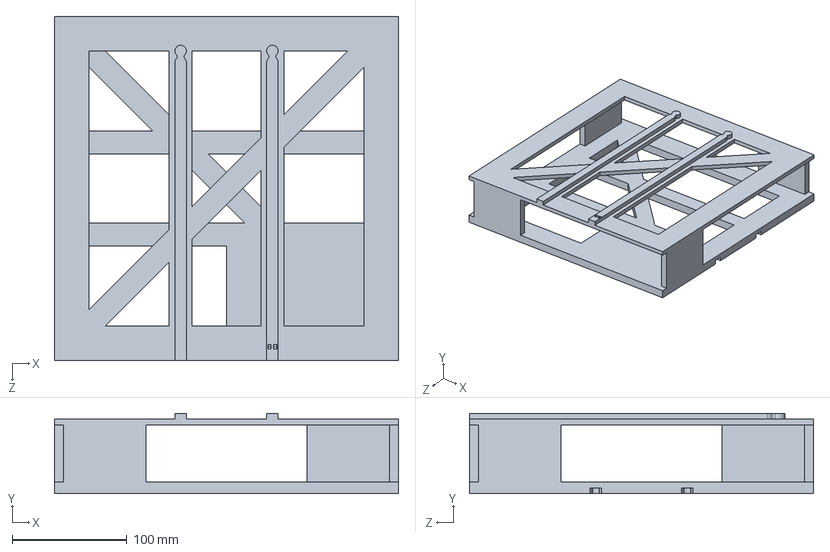
[picture p64: CAD file, 2013-06-06]
Design/Module Communication Port.SLDPRT
300.0 x 70.0 x 300.0 mm
