princeedward/senior_thesis/Design/Module Sensor Support.SLDPRT

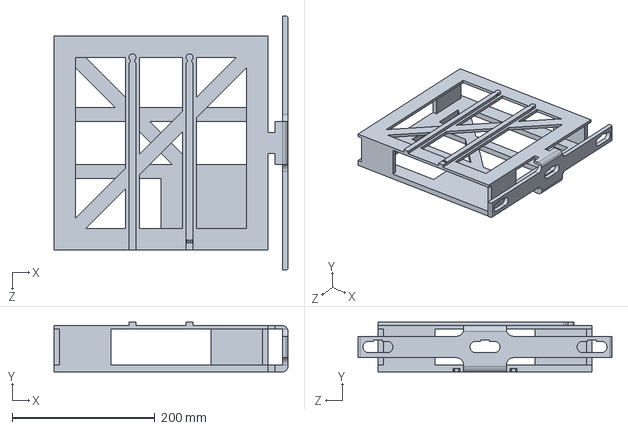
[picture p65: CAD file, 2013-06-06]
Design/Module Sensor Support.SLDPRT
328.0 x 70.0 x 356.0 mm
