princeedward/senior_thesis/(list of files, cad)

Other CAD files:
Design/Module Model.SLDPRT
Design/Encoder Wheel Pr.SLDDRW
