princeedward/senior_thesis/Design/Encoder Wheel Pr.PDF

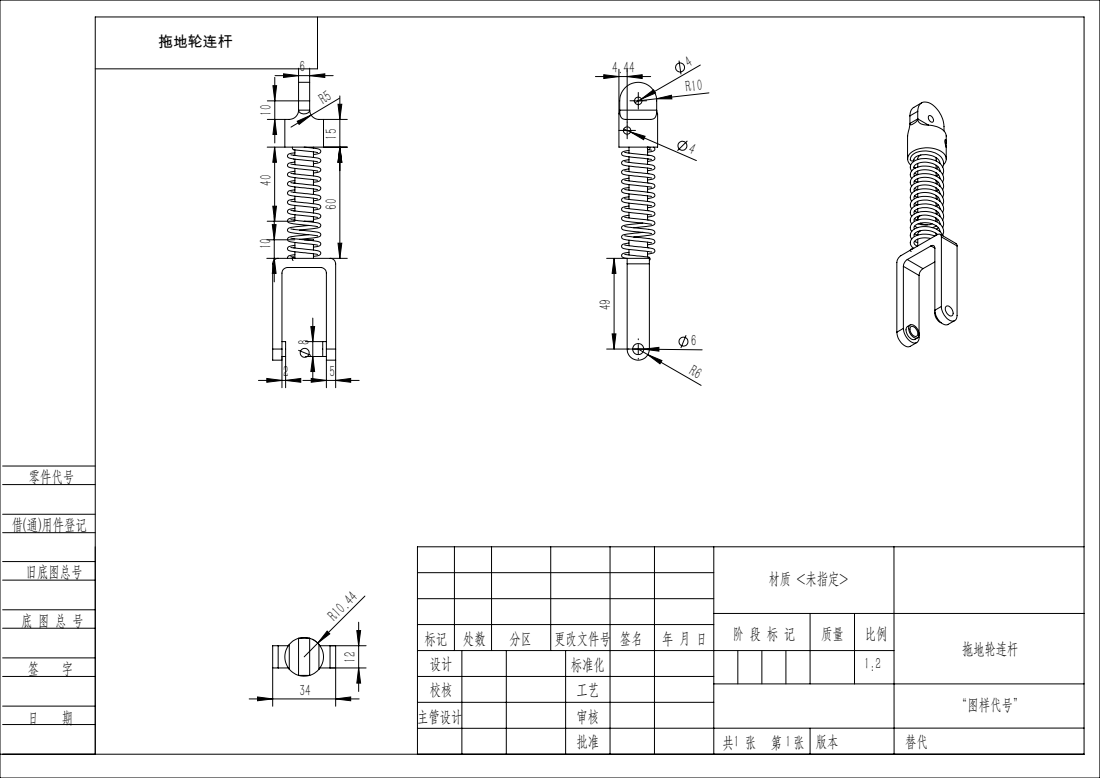
[picture p68: page 1]
材质 <未指定>

标记 | 处数 | 分区 | 更改文件号 | 签名 | 年 月 日
设计 | | | 标准化 | | | | | | 1:2
校核 | | | 工艺
主管设计 | | | 审核

“图样代号”
