princeedward/senior_thesis/Tex/temptest.pdf

׾

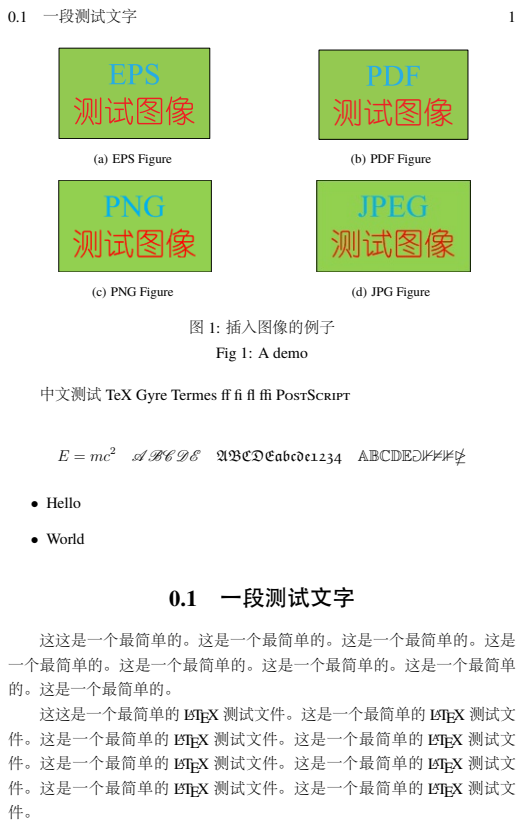
[picture p69: page 1]
0.1 一段测试文字; (a) EPS Figure; (b) PDF Figure; (c) PNG Figure; (d) JPG Figure; 图 1: 插入图像的例子; Fig 1: A demo; • Hello; • World

中文测试 TeX Gyre Termes ff fi fl ffi PS

E = mc² A BC DE ABCDEabcde1234 ABCDEa1234

这这是一个最简单的。这是一个最简单的。这是一个最简单的。这是
一个最简单的。这是一个最简单的。这是一个最简单的。这是一个最简单
的。这是一个最简单的。
这这是一个最简单的 LATEX 测试文件。这是一个最简单的 LATEX 测试文
件。这是一个最简单的 LATEX 测试文件。这是一个最简单的 LATEX 测试文

2

上海交通大学是我国历史最悠久的高等学府之一，是教育部直属、教 育部与上海市共建的全国重点大学，是国家“七五”、“八五”重点建设和 “211 工程”、“985 工程”的首批建设高校。经过 115 年的不懈努力，上海 交通大学已经成为一所“综合性、研究型、国际化”的国内一流、国际知 名大学，并正在向世界一流大学稳步迈进。
