princeedward/senior_thesis/Tex/figures/chap3/Core.pdf

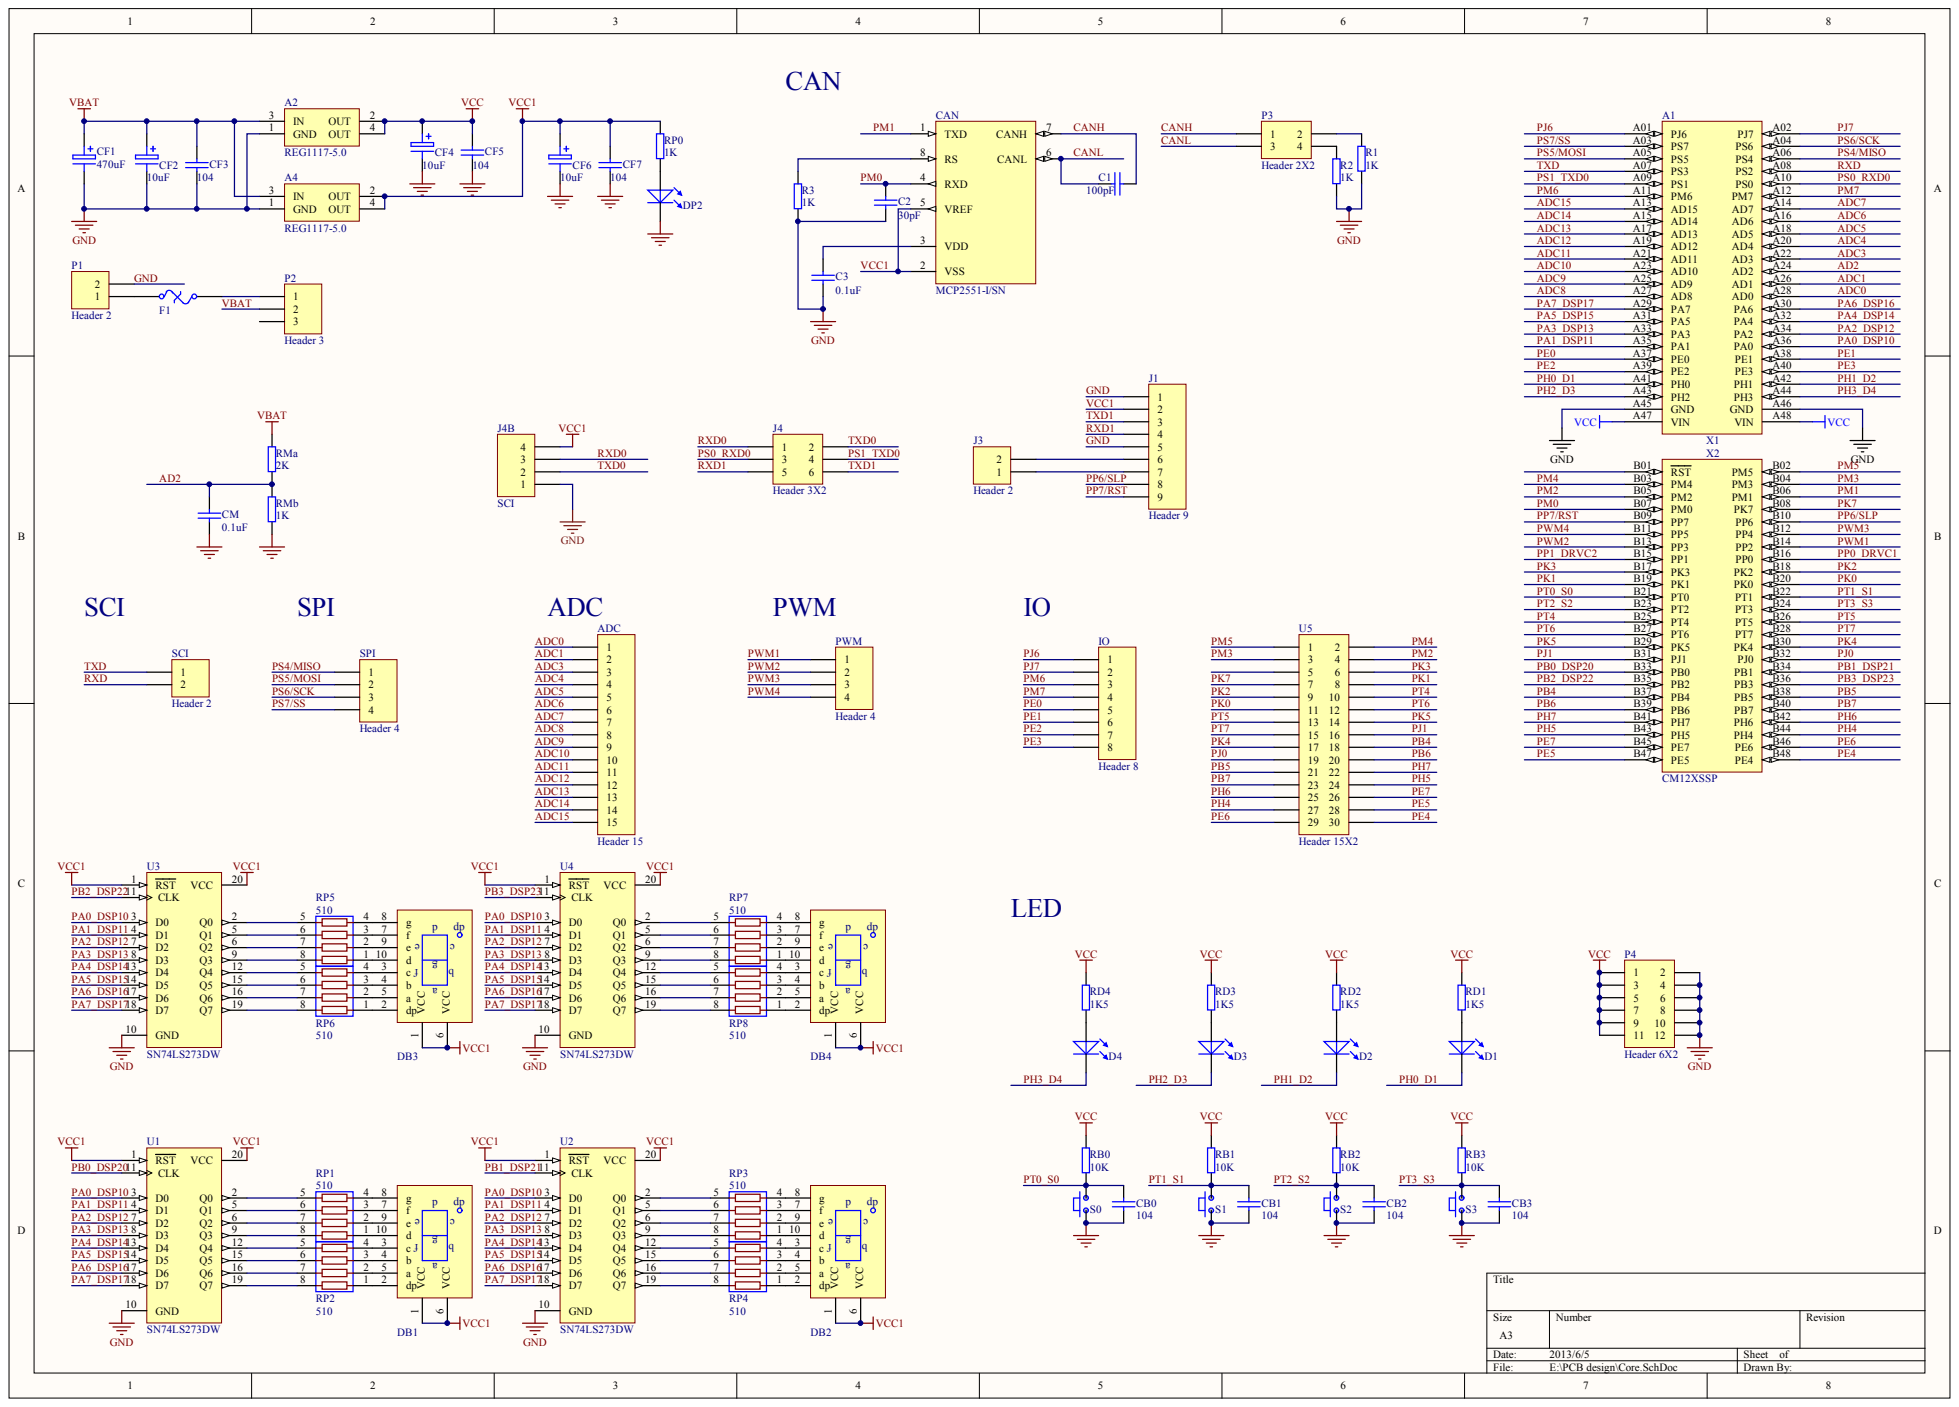
[picture p70: page 1]

30pF | VDD 3

VSS 2
