princeedward/senior_thesis/Tex/figures/chap3/Core112V2.pdf

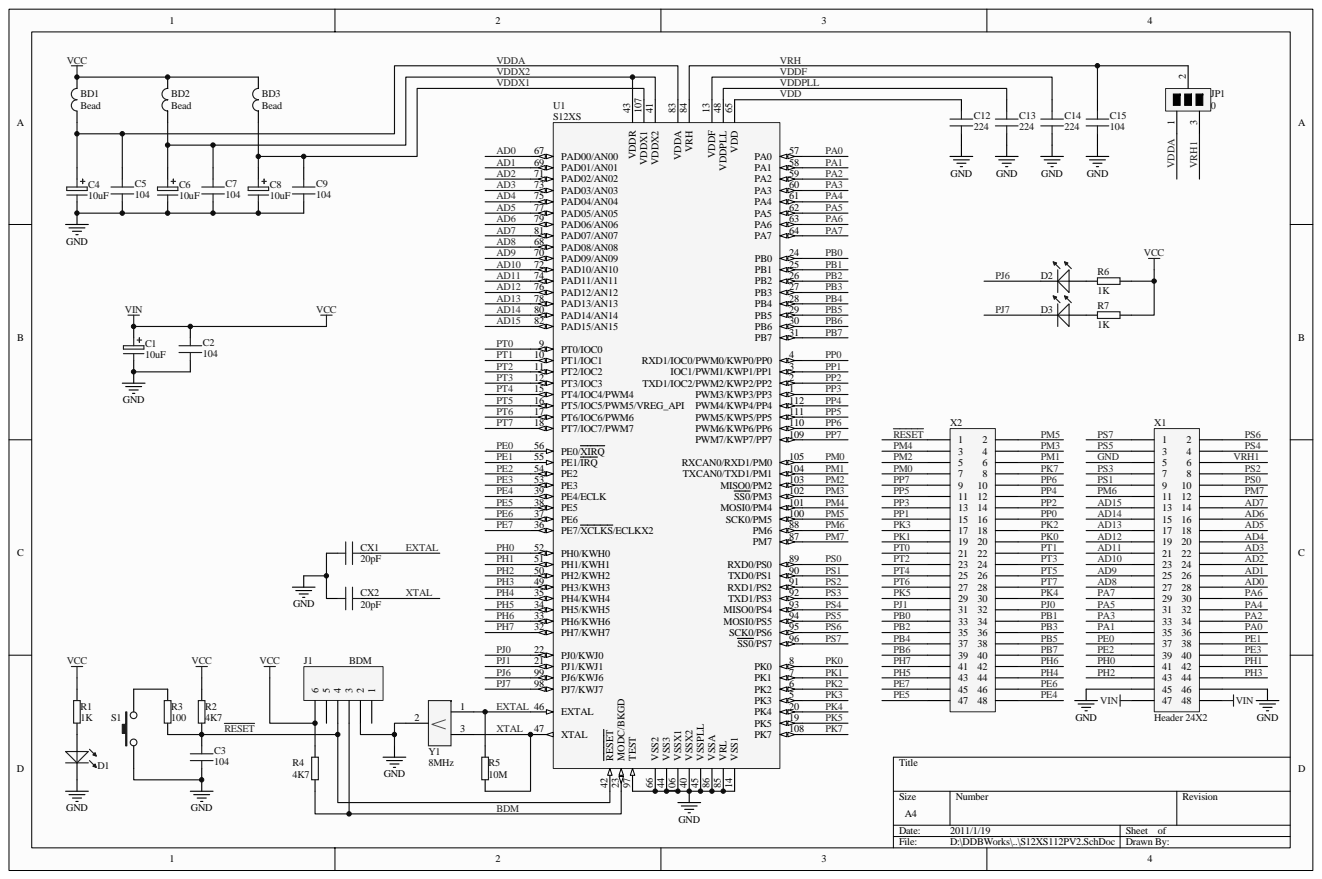
[picture p71: page 1]

Size A4 | Number | Revision

Date: 2011/1/19 | Sheet of
File: D:\DDBWorks\..\S12XS112PV2.SchDoc | Drawn By:
