princeedward/senior_thesis/(commit log)

2013-06-04 The inital submission
    [model.sdf, sjtuthesis.cfg]
2013-06-05 include figures for core board
2013-06-06 Finish the mechanical design part, include tex file and 3D model
    [Axial.SLDPRT, Encode Wheel Structure.SLDASM, Encoder Wheel.SLDPRT, Module Communication Port.SLDPRT, Module Model.SLDPRT, Module Sensor Support.SLDPRT, Upper Link.SLDPRT, Wheel.SLDPRT]
2013-06-13 modified first 2 chapters
    [Encoder Wheel Pr.SLDDRW, Encoder Wheel Spring.SLDPRT, Encoder Wheel.SLDPRT]
